kreier/T300/archive/README.md

# Archive

This folder contains the history of the ongoing progress in programming the robot and the inclusion of more sensors and actors.
