kreier/T300/motorshield/L298P-Motor-Driver-Shield-Analog-Digital-Sensor-Inputs.jpg

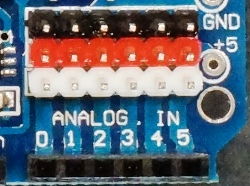
motorshield/L298P-Motor-Driver-Shield-Analog-Digital-Sensor-Inputs.jpg
