kreier/T300/motorshield/L298P-Motor-Driver-Shield-Bluetooth-Headers.jpg

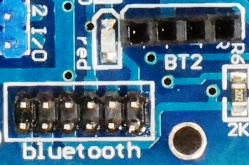
motorshield/L298P-Motor-Driver-Shield-Bluetooth-Headers.jpg
