kreier/T300/motorshield/L298P-Motor-Driver-Shield-Digital-Sensor-Input.jpg

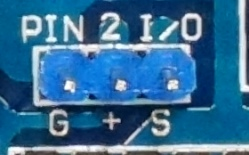
motorshield/L298P-Motor-Driver-Shield-Digital-Sensor-Input.jpg
