kreier/T300/motorshield/L298P-Motor-Driver-Shield-Motor-Connections.jpg

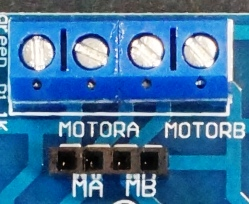
motorshield/L298P-Motor-Driver-Shield-Motor-Connections.jpg
