kreier/T300/motorshield/L298P-Motor-Driver-Shield-Ping-Sensor-Header.jpg

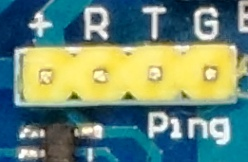
motorshield/L298P-Motor-Driver-Shield-Ping-Sensor-Header.jpg
