kreier/T300/archive/materials_T300.xlsx

nr | name | amount | unit price | price | link
1 | Arduino Leonardo | 1 | 125000 VND | 125000 VND | https://icdayroi.com/arduino-leonardo-r3
2 | Robot base 4 wheels | 1 | 140000 VND | 140000 VND | https://icdayroi.com/khung-xe-robot-4-banh
3 | Motor Shield L298 | 1 | 120000 VND | 120000 VND | https://icdayroi.com/arduino-motor-shield-l298
4 | Bluetooth AT-09 | 1 | 75000 VND | 75000 VND | https://icdayroi.com/mach-thu-phat-bluetooth-4-0-uart-cc2541-at-09
5 | Battery 18650 3.7V | 2 | 35000 VND | 70000 VND | https://icdayroi.com/pin-cell-18650-4200mah-3-7v
6 | Battery holder 2C 18650 | 1 | 7000 VND | 7000 VND | https://icdayroi.com/hop-de-pin-18650-loai-2-cell
7 | Power switch MTS 102 | 1 | 4000 VND | 4000 VND | https://icdayroi.com/cong-tac-mts-102
8 | Battery voltage display | 1 | 22000 VND | 22000 VND | https://icdayroi.com/dong-ho-do-von-volt-3-5-30v
9 | Servo SG90 | 5 | 29000 VND | 145000 VND | https://icdayroi.com/servo-sg90
10 | Ultrasonic module HC-SR04 | 1 | 20000 VND | 20000 VND | https://icdayroi.com/cam-bien-sieu-am-hc-sr04
11 | Robot 4DOF kit | 1 | 246000 VND | 246000 VND | https://www.lazada.vn/products/4-dof-acrylic-chua-lap-rap-diy-canh-tay-robot-diy-bo-cho-arduino-may-lam-ho-tro-hoc-tap-sg90-servo-i267650656-s391094259.html
12 | Wires DuPont MF and FF | 20 | 300 VND | 6000 VND | https://thegioiic.com/products/day-be-cai-cai-dai-15cm
13 | Voltmeter for Battery | 1 | 21000 VND | 21000 VND | https://thegioiic.com/products/dong-ho-do-ap-dc-2-5-30vdc
14 | Display 1602 3.3V white/blue | 1 | 32000 VND | 32000 VND | https://thegioiic.com/products/lcd-1602-nen-xanh-duong-chu-trang-3-3v
15 | I2C serial to parallel adapter | 1 | 13500 VND | 13500 VND | https://thegioiic.com/products/mach-giao-tiep-lcd-ky-tu-sang-i2c
 |  |  |  | 1046500 VND
