kreier/T300/robotarm/Sweep2.ino

/* Sweep
 by BARRAGAN <http://barraganstudio.com>
 This example code is in the public domain.

 modified 8 Nov 2013
 by Scott Fitzgerald
 http://www.arduino.cc/en/Tutorial/Sweep
*/

#include <Servo.h>

Servo myservo;  // create servo object to control a servo
Servo m2servo;
// twelve servo objects can be created on most boards

int pos = 0;    // variable to store the servo position

void setup() {
  pinMode(4, OUTPUT);
  myservo.attach(9);  // attaches the servo on pin 9 to the servo object
  m2servo.attach(A0);
  digitalWrite(4, HIGH);
  delay(100);
  digitalWrite(4, LOW);
}

void loop() {
  for (pos = 0; pos <= 180; pos += 1) { // goes from 0 degrees to 180 degrees
    // in steps of 1 degree
    myservo.write(pos);              // tell servo to go to position in variable 'pos'
    m2servo.write(pos);
    delay(15);                       // waits 15ms for the servo to reach the position
  }
  for (pos = 180; pos >= 0; pos -= 1) { // goes from 180 degrees to 0 degrees
    myservo.write(pos);              // tell servo to go to position in variable 'pos'
    m2servo.write(pos);
    delay(15);                       // waits 15ms for the servo to reach the position
  }
  myservo.write(90);
  m2servo.write(90);
  delay(2000);
  digitalWrite(4, HIGH);
  delay(100);
  digitalWrite(4, LOW);
  delay(100);
  digitalWrite(4, HIGH);
  delay(100);
  digitalWrite(4, LOW);
}
