kreier/T300/motorshield/test_simple1.ino

int E1 = 10; // enable - with PWM
int M1 = 12;
int E2 = 11;
int M2 = 13;

void setup() {
  pinMode(M1, OUTPUT); // no need for analog output
  pinMode(M2, OUTPUT);
  delay(3000); // wait a 3 seconds  
  // enable
  analogWrite(E1, 128);// not so fast - down by 50%
  analogWrite(E2, 128);
}

void loop() {
  // forward
  digitalWrite(M1, HIGH);
  digitalWrite(M2, HIGH);
  delay(1000);
  // backward
  digitalWrite(M1, LOW);
  digitalWrite(M2, LOW);
  delay(1000);
  // left
  digitalWrite(M1, LOW);
  digitalWrite(M2, HIGH);
  delay(1000);
  // right
  digitalWrite(M1, HIGH);
  digitalWrite(M2, LOW);
  delay(1000);  
}
