kreier/T300/(commit log)

2019-11-20 empty frame, will be designed in spring 2020
2019-11-21 pin assignment
2019-11-21 update pin assignment, include I2C
2019-11-21 pin and remote updated
2019-11-21 three stages autonomous movement
2019-11-25 pin assignment updated
2019-12-02 mode selection and I2C display works
2019-12-02 Bluetooth mode selection, display on 1602 I2C
2019-12-09 no errors like LiquidCrystal_I2C
    [ultrasonic_lcd1602_hd44780.ino]
2019-12-09 with ultrasonic stop function under 10cm
2019-12-11 PWM issues fixed, code structured
    [latest.ino]
2019-12-13 pwm control works - without servo and ultrasonic
2019-12-16 servo and sonar removed to investigate PWM issue
    [2019-12-13_no_sonar.ino]
2019-12-16 PWM and servo timer issue fixed with reboot()
    [latest.ino]
2019-12-16 detail images of motor shield
2019-12-17 included hits! (how idiots track success)
2019-12-19 switch to MIT license
2019-12-26 material list updated
2019-12-26 materials list as of 2019
    [materials_T300.xlsx]
2026-10-26 Add .gitignore file with common patterns for Arduino (CPP)
